ElectronDon66/Lightning-Detector-Ver2.0/Amplifier board.pdf

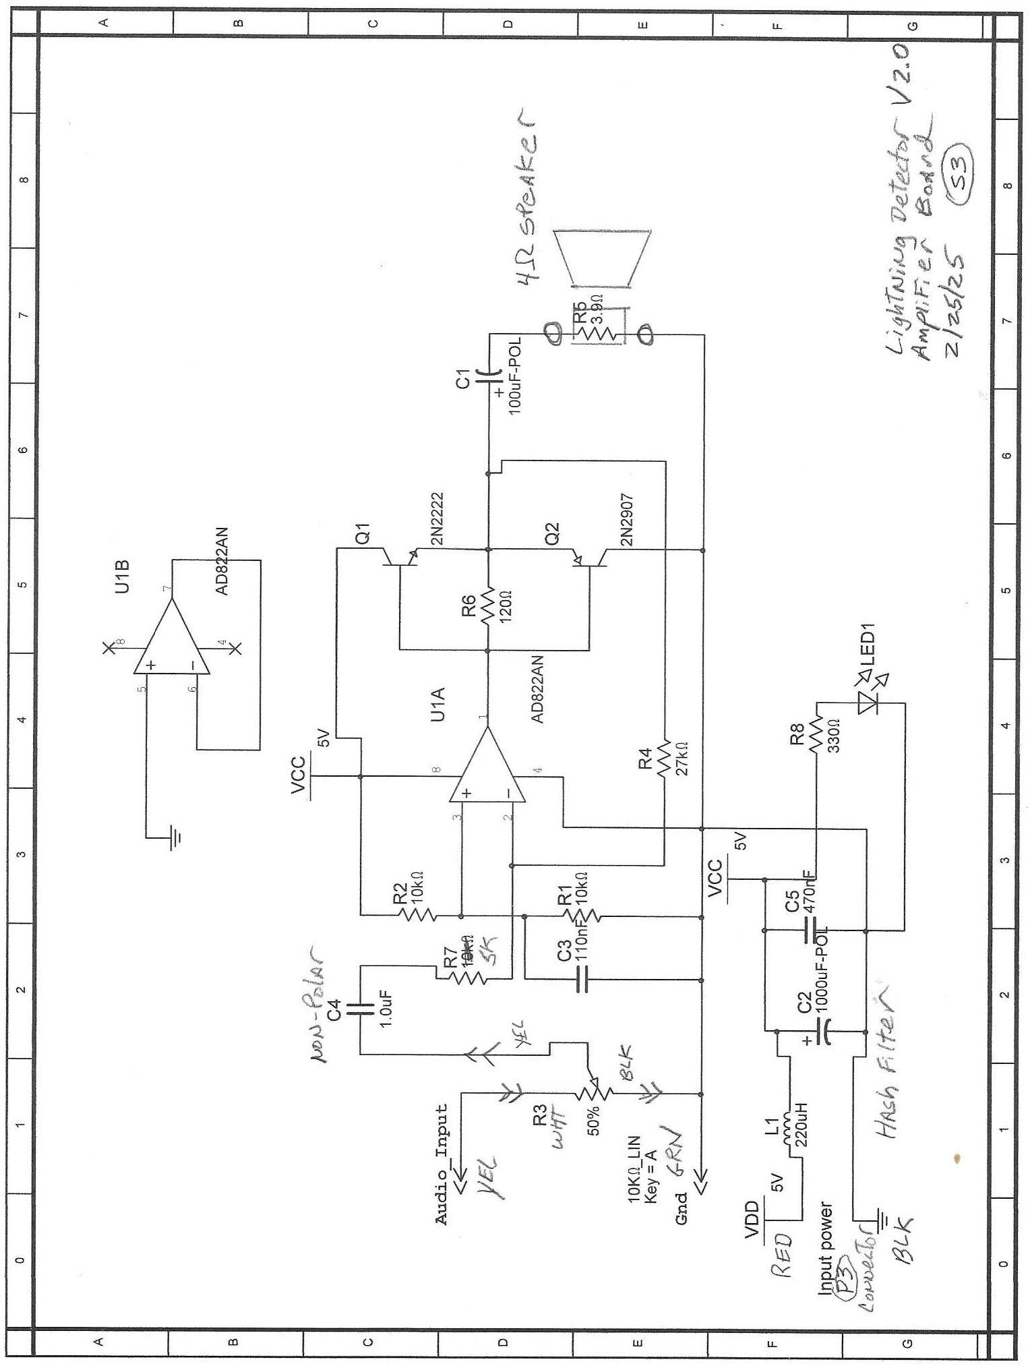
[picture p1: page 1]
