ElectronDon66/Lightning-Detector-Ver2.0/FX sound board.pdf

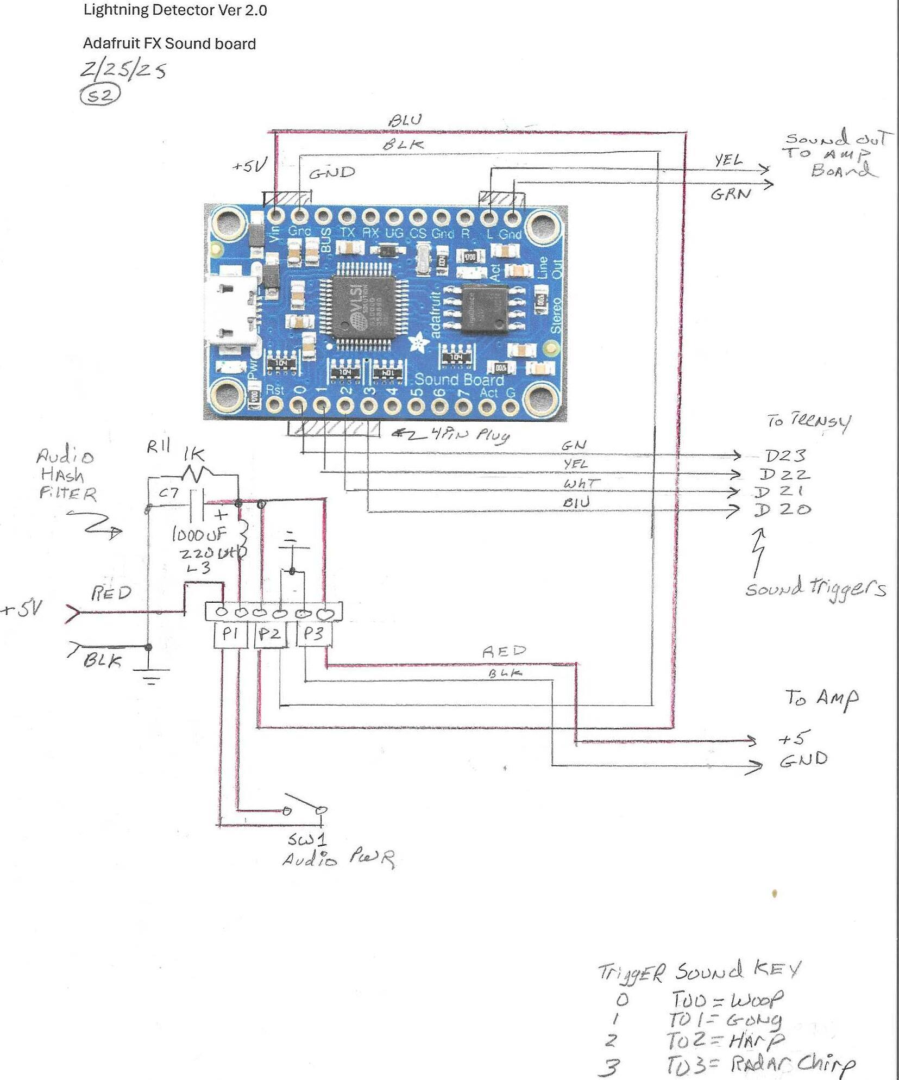
[picture p2: page 1]
