ElectronDon66/Lightning-Detector-Ver2.0/main board with Microcontroller.pdf

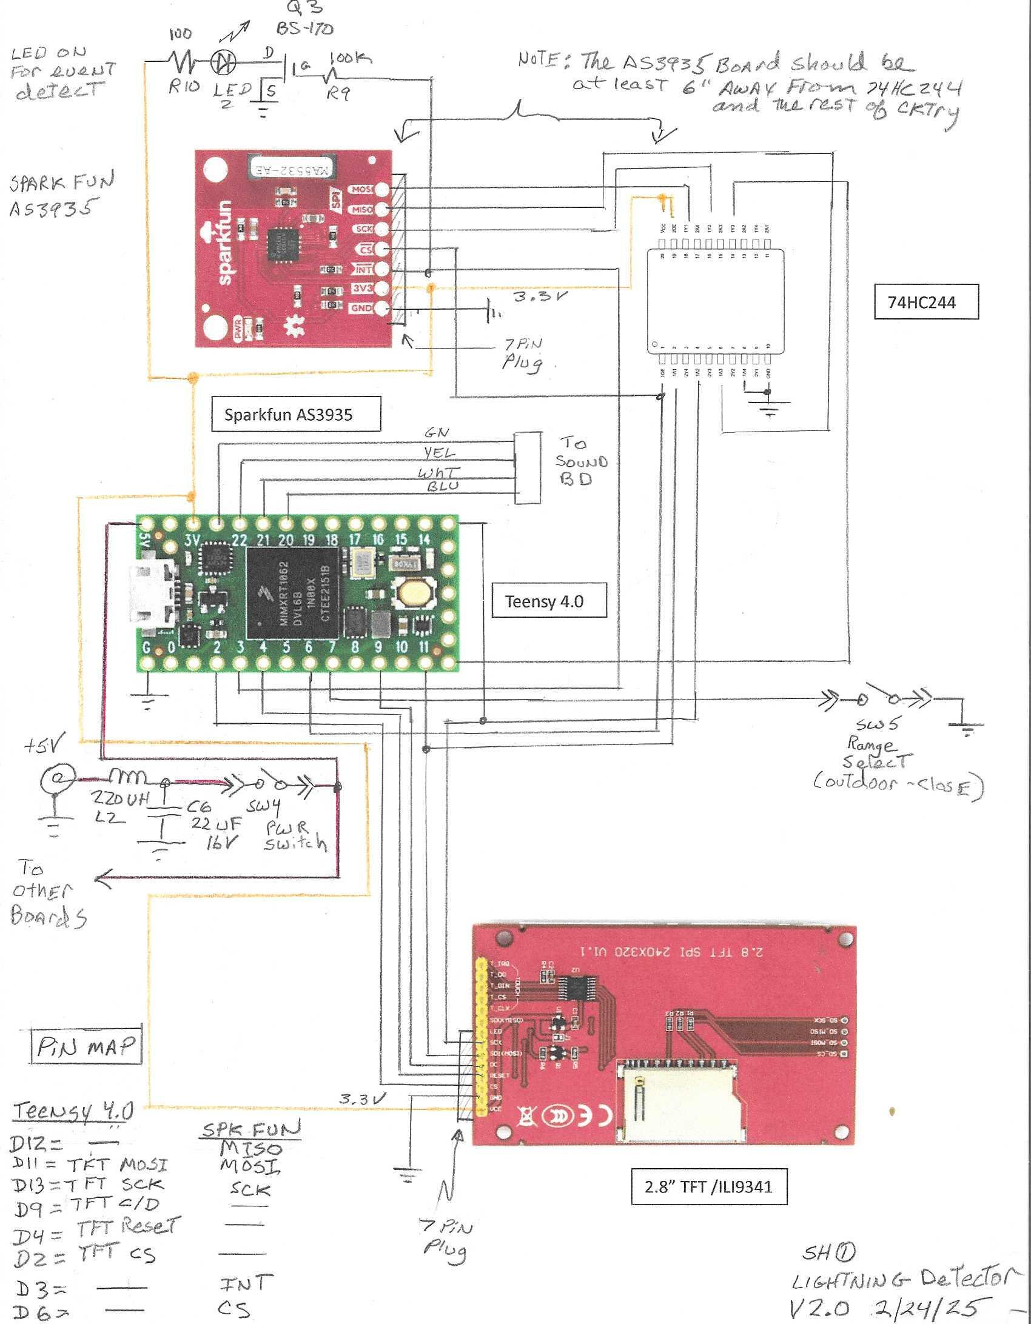
[picture p3: page 1]
